Institute-of-Biomedical-Sciences/dynamic-cell-culture-drive/Hardware design files/readme.md

# Hardware design files
This folder contains CAD files of the motion drive modules. Each file contains all custom-designed components that require separate manufacturing, e.g. by CNC machining or 3D printing.
