Institute-of-Biomedical-Sciences/dynamic-cell-culture-drive/docs/incubator-use/cable-plug.png

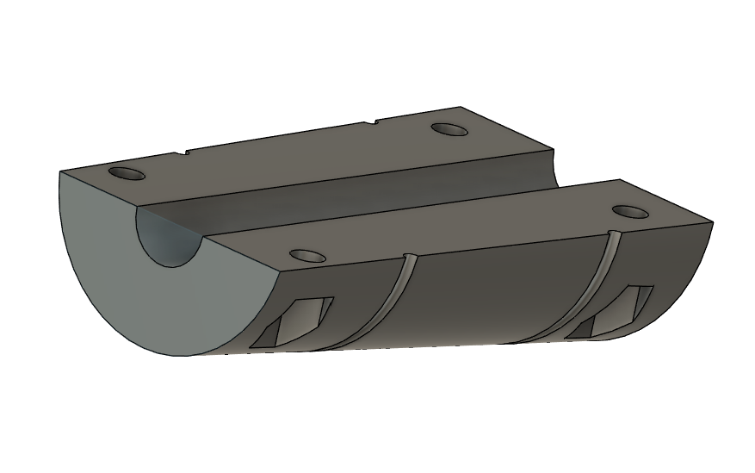
docs/incubator-use/cable-plug.png
