Institute-of-Biomedical-Sciences/dynamic-cell-culture-drive/frontend/src/assets/images/IoBS.png

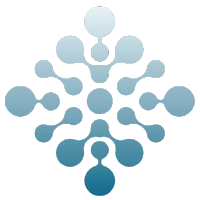
frontend/src/assets/images/IoBS.png
