Institute-of-Biomedical-Sciences/dynamic-cell-culture-drive/frontend/src/assets/images/peristaltic-motor.gif

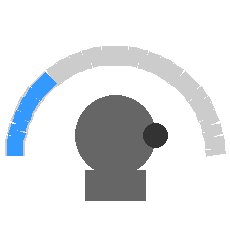
frontend/src/assets/images/peristaltic-motor.gif
