Institute-of-Biomedical-Sciences/dynamic-cell-culture-drive/frontend/src/assets/images/rotary-motor.gif

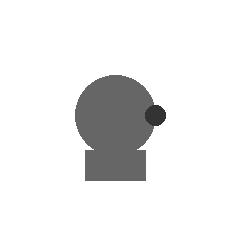
frontend/src/assets/images/rotary-motor.gif
