Institute-of-Biomedical-Sciences/dynamic-cell-culture-drive/frontend/src/assets/images/tilt-motor.gif

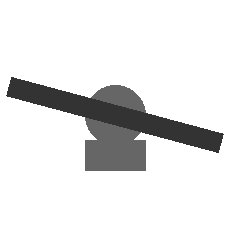
frontend/src/assets/images/tilt-motor.gif
