Institute-of-Biomedical-Sciences/dynamic-cell-culture-drive/liquid handling/graphics/peristaltic.jpeg

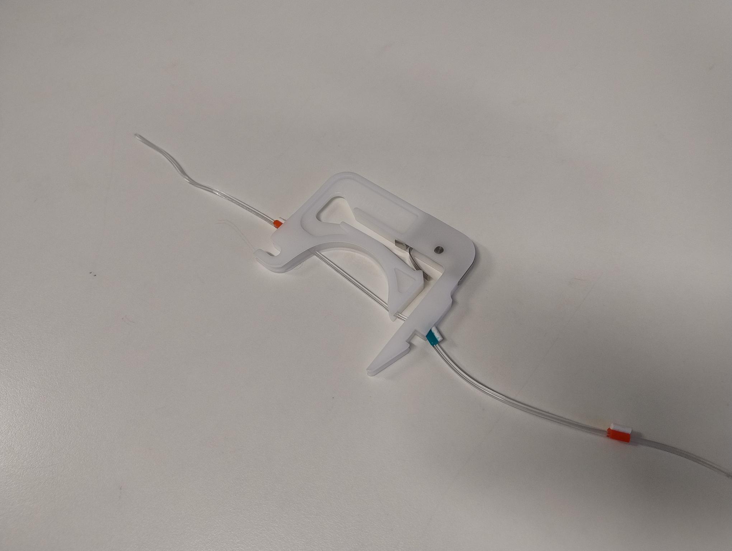
liquid handling/graphics/peristaltic.jpeg
