Institute-of-Biomedical-Sciences/dynamic-cell-culture-drive/liquid handling/graphics/rocking-plate-holder.png

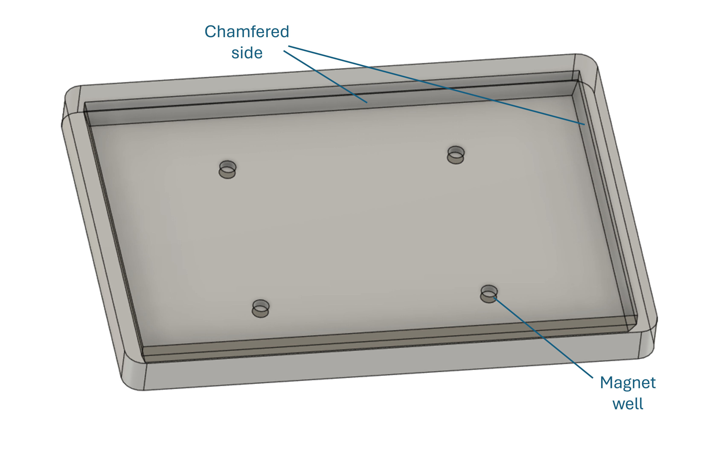
liquid handling/graphics/rocking-plate-holder.png
