Institute-of-Biomedical-Sciences/dynamic-cell-culture-drive/docs/assembly/BOM/BOM.xlsx

BOM
Modul A |  | Modul B |  | Peristaltic pump |  | Electronic box
Name | No. of pieces | Name | No. of pieces | Name | No. of pieces | Name | Description | No. of pieces
Nema 23 stepper motor _x0003_w reductor 1-50 | 1 | Nema 23 stepper motor w reductor 1-50 | 1 | Nema 34 stepper motor | 1 | Housing |  | 1
Base plate | 1 | Base plate | 1 | Base plate | 1 | Housing lid |  | 1
Motor adapter | 1 | Motor adapter | 1 | Motor adapter | 1 | AC/DC Power Supply | Mean Well LRS-100-24 | 1
Magnetic coupler | 1 | Magnetic coupler | 1 | Coupler | 1 | Stepper Motor Driver Board | PoStep60-256 | 1
Magnet 6x3 mm | 4 | Magnet 6x3 mm | 4 | Peristaltic pump | 1 | Breakout PCB | planet-cnc | 1
Screw M5x16 | 6 | Coupler | 1 | Screw M4x16 | 2 | IEC C14 Power Inlet |  | 1
 |  | Proximity sensor | 1 | Screw M5x16 | 2 | Connector | WEIPU SF1210/P7 | 1
 |  | Screw M5x16 | 6 | Screw M6x20 | 8 | Screw for plastic 10x3mm countersunk |  | 8
 |  | Screw M4x20 | 4
 |  | Screw M3x8 | 2
