Institute-of-Biomedical-Sciences/dynamic-cell-culture-drive/Hardware design files/Rocking module assembly.STEP

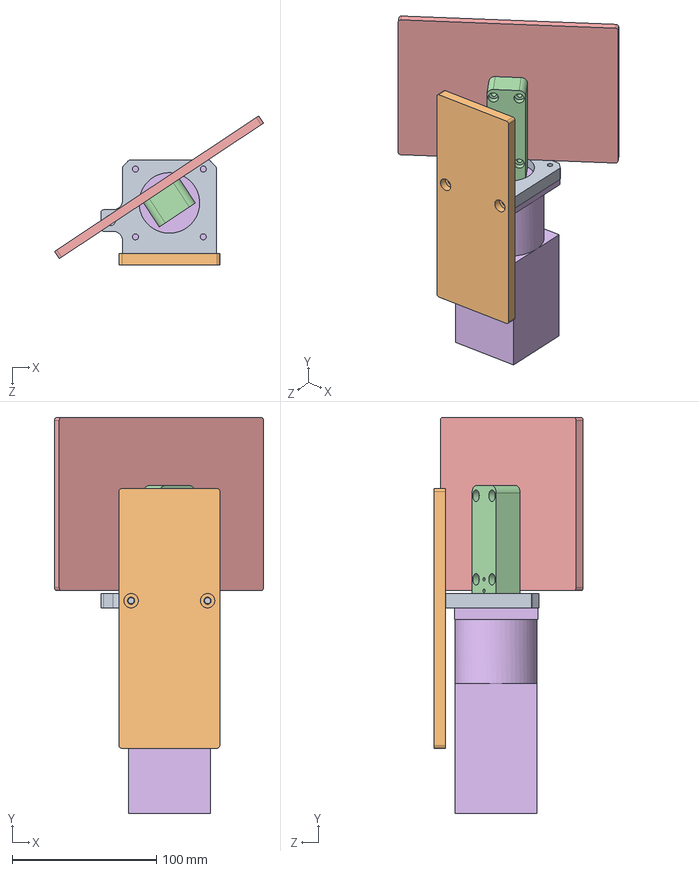
[picture p15: CAD file, 2026-02-10]
Hardware design files/Rocking module assembly.STEP
145.0 x 274.5 x 103.4 mm
nema 17 adapter
nema 17 base
Magnet 6x3 x 4
Magnetic coupler 1B
Ploscad 1B
Nema 23 reduktor 1-50
