Institute-of-Biomedical-Sciences/dynamic-cell-culture-drive/Hardware design files/Rotary module assembly.STEP

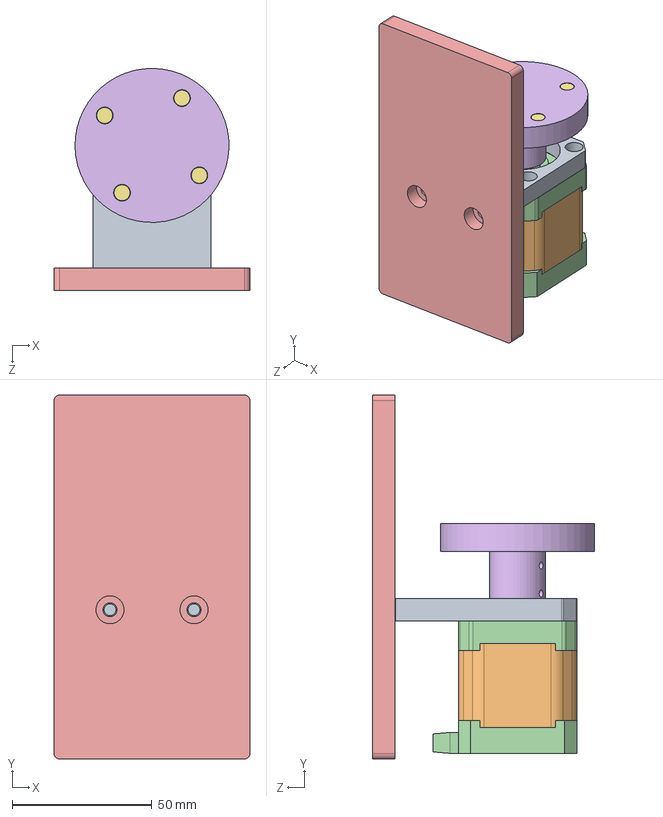
[picture p17: CAD file, 2026-02-10]
Hardware design files/Rotary module assembly.STEP
70.0 x 130.0 x 79.3 mm
nema 17 adapter
stepper motor NEMA 17
nema 17 base
Magnetic coupler 1A
Magnet 6x3 x 4
