Institute-of-Biomedical-Sciences/dynamic-cell-culture-drive/docs/incubator-use/cable-plug.step

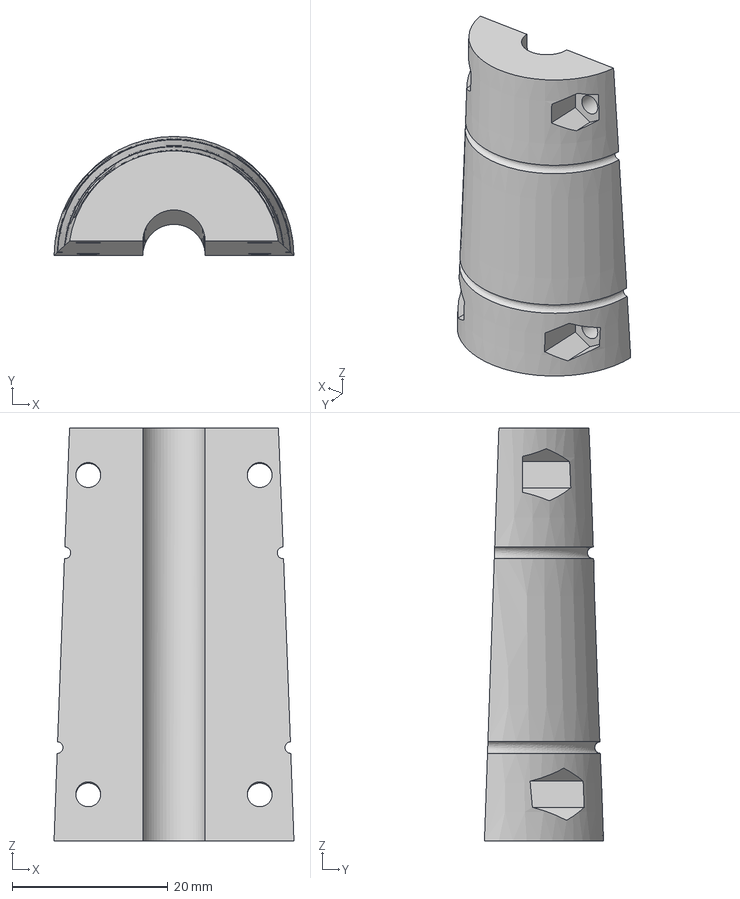
[picture p18: CAD file, 2026-02-24]
docs/incubator-use/cable-plug.step
30.8 x 15.3 x 53.0 mm
