Institute-of-Biomedical-Sciences/dynamic-cell-culture-drive/liquid handling/rocking-multiwell-holder.stl

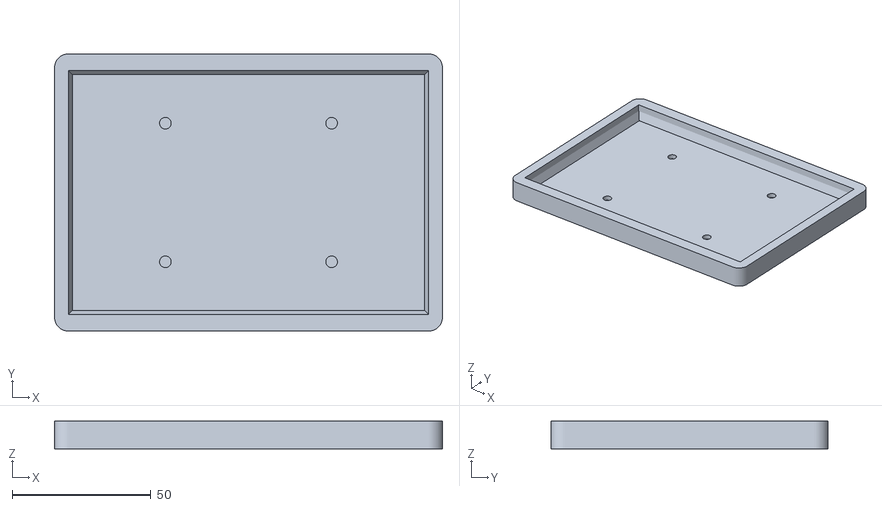
[picture p19: CAD file, 2026-02-12]
liquid handling/rocking-multiwell-holder.stl
140.0 x 100.0 x 10.0
