Institute-of-Biomedical-Sciences/dynamic-cell-culture-drive/liquid handling/rocking-P6-skin.stl

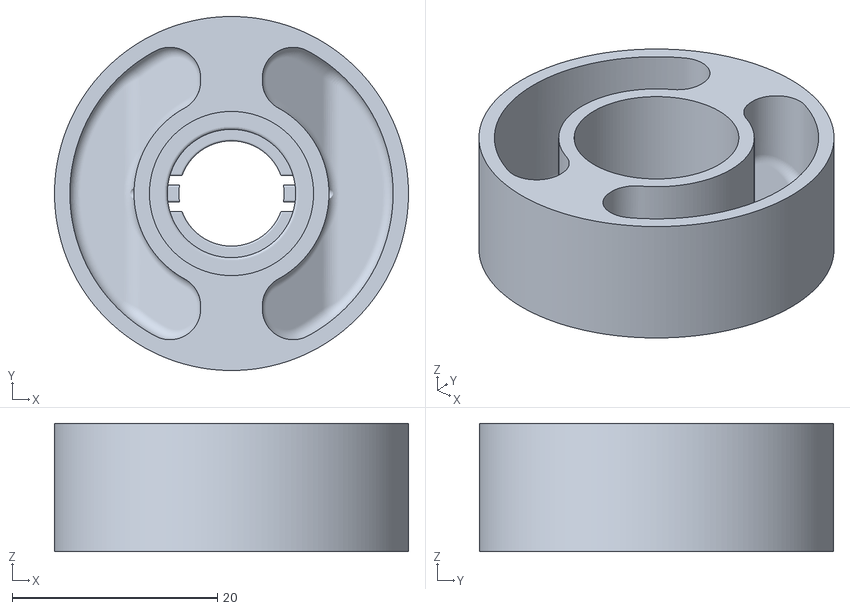
[picture p20: CAD file, 2026-02-10]
liquid handling/rocking-P6-skin.stl
34.5 x 34.5 x 12.5
