Institute-of-Biomedical-Sciences/dynamic-cell-culture-drive/liquid handling/rotary-4x-simple-7mm-tube-base.stl

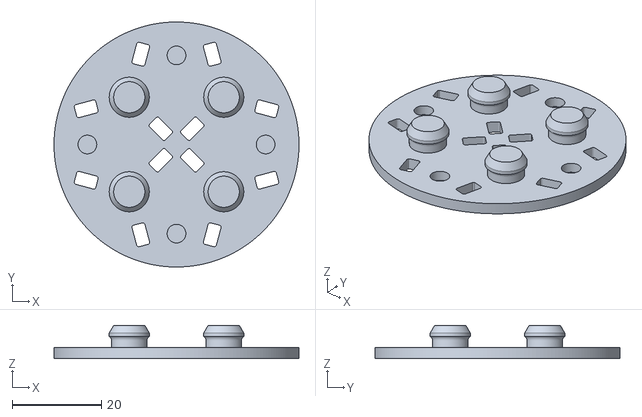
[picture p21: CAD file, 2026-02-10]
liquid handling/rotary-4x-simple-7mm-tube-base.stl
55.0 x 55.0 x 7.50
