Institute-of-Biomedical-Sciences/dynamic-cell-culture-drive/liquid handling/rotary-4x-simple-7mm-tube-top.stl

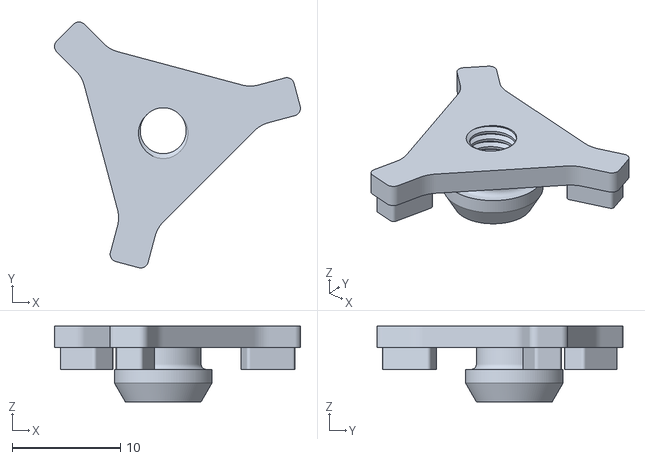
[picture p22: CAD file, 2026-02-10]
liquid handling/rotary-4x-simple-7mm-tube-top.stl
22.7 x 22.7 x 7.00
