Institute-of-Biomedical-Sciences/dynamic-cell-culture-drive/(list of files, cad)

Other CAD files:
Hardware design files/Peristaltic module assembly.STEP
