Institute-of-Biomedical-Sciences/dynamic-cell-culture-drive/liquid handling/graphics/rotary-assembly-1x.jpeg

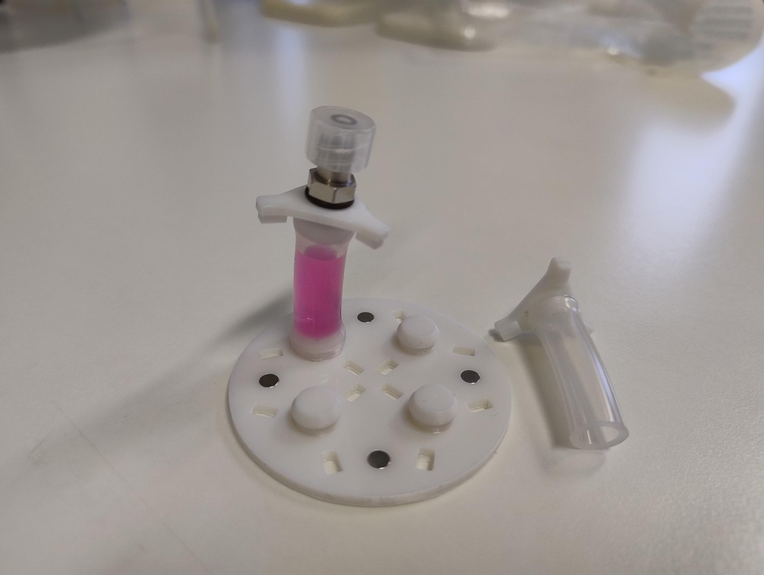
liquid handling/graphics/rotary-assembly-1x.jpeg
