Institute-of-Biomedical-Sciences/dynamic-cell-culture-drive/(commit log)

2026-02-03 feat: visual changes, link fix, add graphics for instructions
    [BOM.xlsx]
2026-02-04 docs: update documentation
    [BOM.xlsx]
2026-02-05 fix: read driver settings for windows
    [postep256usb.py]
2026-02-06 fix: bug fixes for calibration and rotate
    [peristaltic_motor.py, peristaltic_motor_api.py]
2026-02-09 feat: multiple bug fix, update button on fe
    [peristaltic_motor.py, peristaltic_motor_api.py, postep256_handler.py, rotary_motor.py]
2026-02-09 fix: bugfix and minor changes 2
    [peristaltic_motor.py, peristaltic_motor_api.py, rotary_motor.py]
2026-02-10 Update and rename Peristaltic assembly.STEP to Hardware design files/Peristaltic assembly.STEP
    [Peristaltic assembly.STEP]
2026-02-10 Update and rename Module A - assembly.STEP to Rotary module - assembly.STEP
    [Rotary module - assembly.STEP]
2026-02-10 Update and rename Peristaltic assembly.STEP to Peristaltic module assembly.STEP
    [Peristaltic module assembly.STEP]
2026-02-10 Update and rename Module B - assembly.STEP to Rocking module assembly.STEP
    [Rocking module assembly.STEP]
2026-02-10 Update and rename Rotary module - assembly.STEP to Rotary module assembly.STEP
    [Rotary module assembly.STEP]
2026-02-13 feat: long run reduce measurements for computing power saving
2026-02-20 feat: mini bugfix - peristaltic graph display
    [peristaltic_motor.py]
2026-03-03 fix: homing direction change to fit mechanical change
    [tilt_motor.py]
